fangxx3863/USB-DAC-PRO/extra/README.md

# 注意事项

PCB文件已经过验证可用,导入立创EDA专业版打样即可  
附件中也提供了对应的制版文件,可到其他平台打样  

特别注意，运放假货众多，请甄别店铺可靠性  

# 修订
DAC的有源晶振频率不低于40MHz即可，最高100MHz  
低于50MHz的晶振可取消DAC的1.5V供电  
更多元件参数信息参照电路原理图与PCB  

# 元件购买

物料清单如下(所有物品均可在淘宝找到)  
由于阻容数量众多这里不一一列出，推荐直接购买电阻/电容本  

名称      |数量
---------|----------
50x20x80铝合金外壳|1
CT7601SR芯片|1
12MHz无源晶振|1
GD25Q40CEIGR闪存|1
LED0602侧贴(红/蓝)|2
SRV05瞬态抑制二极管|2
TYPEC-16P母座插脚|2
TPS65131开关电源芯片|1
TPS7A4901线性稳压芯片|1
TPS7A3001线性稳压芯片|1
0530一体成型电感4.7uH|2
SS34肖特基二极管|2
0603磁珠600R@100MHz|2
AO3401 MOS管|2
AO3402 MOS管|1
FPC1.0间距20P母座|2
FPC1.0间距20P反向排线|1
STC8H8K64U-45I-TSSOP20单片机|1
3x4x2贴片2脚开关|1
EC11侧插旋转编码器|1
梅花柄旋钮帽|1
3225 45.1584MHz有源晶振|1
ES9028Q2M DAC芯片|1
OPA1612 运放|2
LM4562 运放|1
LP5907MFX-1.2 LDO线性稳压芯片|1
LP5907MFX-1.5 LDO线性稳压芯片|1
LP5907MFX-3.3 LDO线性稳压芯片|3
PGA2310数字音量电位器|2
TPA6120A2电流运放|2
PJ4.5 4.4mm耳机座|1
PJ3135 3.3mm耳机座|1
0603 100nF 4.7uF 10uF 22uF|20

# 推荐店铺
1. 优信电子
2. 信安源电子
3. 诺亚芯电子
