fangxx3863/USB-DAC-PRO/(list of files, drawings)

Other design files:
extra/PCB/ProPrj_USB-DAC-PRO_2024-06-16.epro
