fangxx3863/USB-DAC-PRO/src/timer.c

/*---------------------------------------------------------------------*/
/* --- STC MCU Limited ------------------------------------------------*/
/* --- STC 1T Series MCU Demo Programme -------------------------------*/
/* --- Mobile: (86)13922805190 ----------------------------------------*/
/* --- Fax: 86-0513-55012956,55012947,55012969 ------------------------*/
/* --- Tel: 86-0513-55012928,55012929,55012966 ------------------------*/
/* --- Web: www.STCMCU.com --------------------------------------------*/
/* --- Web: www.STCMCUDATA.com  ---------------------------------------*/
/* --- QQ:  800003751 -------------------------------------------------*/
/* 如果要在程序中使用此代码,请在程序中注明使用了STC的资料及程序             */
/*---------------------------------------------------------------------*/

#include "stc.h"
#include "timer.h"

#define TM_1MS      (65536 - FOSC/1000)

BOOL f1ms;

void timer_init()
{
    f1ms = 0;
    AUXR |= 0x80;
    TMOD &= ~0x0f;
    TL0 = TM_1MS;
    TH0 = TM_1MS >> 8;
    TR0 = 1;
    ET0 = 1;
}

void delay(u16 ms) {
    u16 i = 0;
    for (i=0; i<ms; i++) {
        f1ms = 0;
        while(!f1ms);
    }
}

void timer0_isr() interrupt 1
{
    f1ms = 1;
}
