fangxx3863/USB-DAC-PRO/src/uart.c

#include "uart.h"
#include "stc32_stc8_usb.h"

#define Baudrate2   115200L
#define UART2_BUF_LENGTH    64

u8  TX2_Cnt;    //发送计数
u8  RX2_Cnt;    //接收计数
bit B_TX2_Busy; //发送忙标志

u8  idata RX2_Buffer[UART2_BUF_LENGTH]; //接收缓冲


//========================================================================
// 函数: void PrintString2(u8 *puts)
// 描述: 串口2发送字符串函数。
// 参数: puts:  字符串指针.
// 返回: none.
// 版本: VER1.0
// 日期: 2014-11-28
// 备注: 
//========================================================================
void PrintString2(u8 *puts)
{
    for (; *puts != 0;  puts++)     //遇到停止符0结束
    {
        S2BUF = *puts;
        B_TX2_Busy = 1;
        while(B_TX2_Busy);
    }
}

//========================================================================
// 函数: SetTimer2Baudraye(u16 dat)
// 描述: 设置Timer2做波特率发生器。
// 参数: dat: Timer2的重装值.
// 返回: none.
// 版本: VER1.0
// 日期: 2014-11-28
// 备注: 
//========================================================================
void SetTimer2Baudraye(u16 dat)  // 使用Timer2做波特率.
{
    AUXR &= ~(1<<4);    //Timer stop
    AUXR &= ~(1<<3);    //Timer2 set As Timer
    AUXR |=  (1<<2);    //Timer2 set as 1T mode
    TH2 = dat / 256;
    TL2 = dat % 256;
    IE2  &= ~(1<<2);    //禁止中断
    AUXR |=  (1<<4);    //Timer run enable
}

//========================================================================
// 函数: void UART2_config(u8 brt)
// 描述: UART2初始化函数。
// 参数: brt: 选择波特率, 2: 使用Timer2做波特率, 其它值: 无效.
// 返回: none.
// 版本: VER1.0
// 日期: 2014-11-28
// 备注: 
//========================================================================
void UART2_config(u8 brt)    // 选择波特率, 2: 使用Timer2做波特率, 其它值: 无效.
{
    /*********** 波特率固定使用定时器2 *****************/
    if(brt == 2)
    {
        SetTimer2Baudraye(65536UL - (FOSC / 4) / Baudrate2);

        S2CON &= ~(1<<7);   // 8位数据, 1位起始位, 1位停止位, 无校验
        IE2   |= 1;         //允许中断
        S2CON |= (1<<4);    //允许接收
        P_SW2 &= ~0x01; 
        P_SW2 |= 1;         //UART2 switch to: 0: P1.0 P1.1,  1: P4.6 P4.7

        B_TX2_Busy = 0;
        TX2_Cnt = 0;
        RX2_Cnt = 0;
    }
}

void UART2_EchoToCDC(void) {
    if((TX2_Cnt != RX2_Cnt) && (!B_TX2_Busy))   //收到数据, 发送空闲
    {
        USB_SendData(&RX2_Buffer[TX2_Cnt], 1);
        if(++TX2_Cnt >= UART2_BUF_LENGTH)   TX2_Cnt = 0;
    }
}

//========================================================================
// 函数: void UART2_int (void) interrupt UART2_VECTOR
// 描述: UART2中断函数。
// 参数: nine.
// 返回: none.
// 版本: VER1.0
// 日期: 2014-11-28
// 备注: 
//========================================================================
void UART2_int (void) interrupt 8
{
    if((S2CON & 1) != 0)
    {
        S2CON &= ~1;    //Clear Rx flag
        RX2_Buffer[RX2_Cnt] = S2BUF;
        if(++RX2_Cnt >= UART2_BUF_LENGTH) RX2_Cnt = 0;
    }

    if((S2CON & 2) != 0)
    {
        S2CON &= ~2;    //Clear Tx flag
        B_TX2_Busy = 0;
    }
}
