fangxx3863/USB-DAC-PRO/(commit log)

2024-02-28 加入更多改版固件
2024-02-29 添加低压中断防止爆音
2024-02-29 修复错误优化体验
    修复了静音状态下扭动旋钮下次无法静音的问题
    添加了用户定义选项
    加入编码器加倍功能
    [encoder.c, main.c, stc.h]
2024-02-29 修复音量调节的上溢与下溢
2024-06-02 更新固件二进制
2024-06-16 更新PCB文件
    [ProPrj_USB-DAC-PRO_2024-06-16.epro, ProProject_USB-DAC-PRO_2024-02-27.epro]
2024-06-16 更新教程
2024-06-16 更新元件购买信息
2024-06-16 更新设计框图
2024-06-16 修正逻辑框图错误
